MathieuMart/flexispot-motionx/(commit log)

2026-11-10 Initial commit: ESP32 firmware, Node.js server, iOS app and docs for the FlexiSpot MotionX walking pad
2026-11-10 Add annotated wiring photo to README and hardware docs
2026-11-10 Translate code, comments and UI to English; add dashboard GIF
    - Firmware, device web page, server, dashboard, iOS app and decoder are now in English
    - State names and session end reasons are English (update, signal_lost, interrupted);
    the iOS app still accepts the former French values
    - README shows an animated dashboard demo instead of the static screenshot
2026-11-11 Replace wiring image with annotations on the real board photo (J1 tap, J5 power)
2026-11-11 Dashboard: live calories and steps, readable speed chart, daily goal, pauses, settings
    - Live stats show time, distance, calories, steps and average speed; the server
    estimates steps and calories of the session in progress (live.est)
    - Speed chart zooms on the speeds actually walked, with 10 min / 30 min / all
    ranges and a pointer readout (same axis in the iOS app)
    - Daily goal (walking time, distance or steps) with progress ring, streak and
    a 7 / 30 day chart
    - Sessions separated by a short pause are shown as one walk; Apple Health still
    receives each part
    - Settings dialog (height, weight, step calibration, goal, pause length) kept
    in data/settings.json
    - Fix the live trace mixin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
